jsve/FourScoreForHomeKit/doc/img/FinishedBack.jpeg

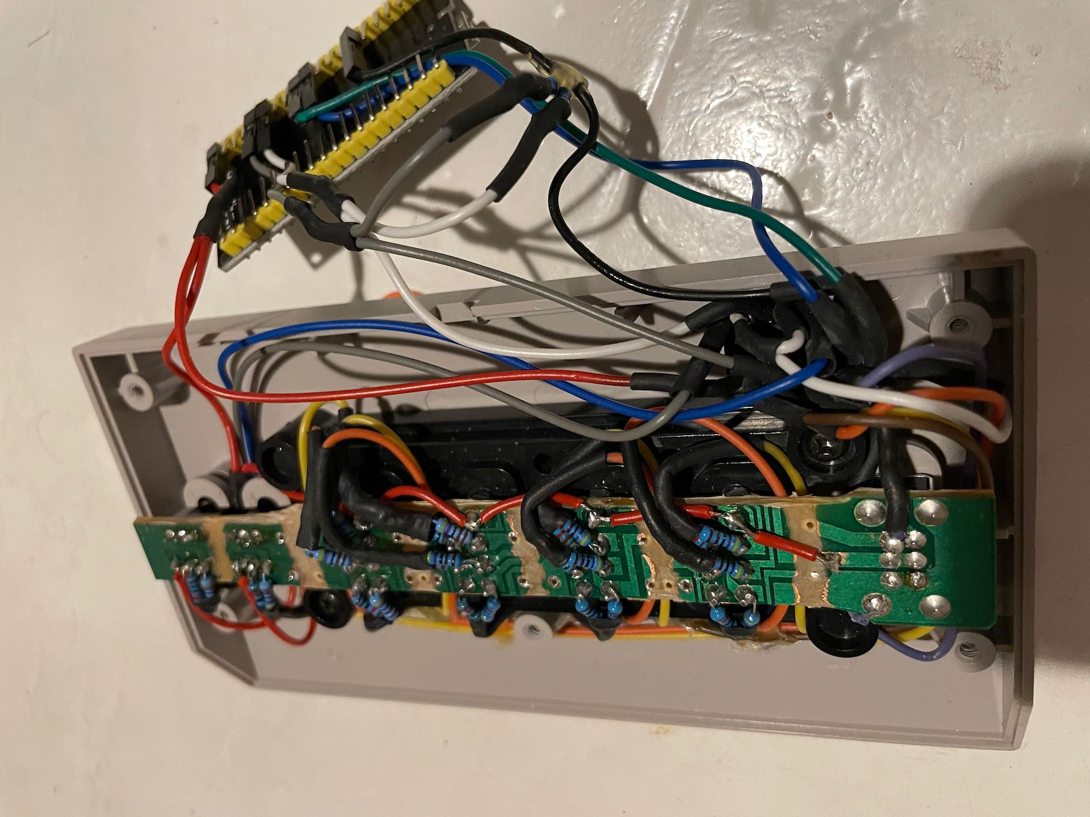
doc/img/FinishedBack.jpeg
